harry123180/AIforSensorCurrent/sch/BOM_Board1_PCB1_2024-08-11.xlsx

No. | Quantity | Comment | Designator | Footprint | Value | Manufacturer Part | Manufacturer | Supplier Part | Supplier | LCSC Stock | JLCPCB Stock | LCSC Price | JLCPCB Price | Layer
1 | 1 | KH-CR1220-2 | BAT1 | BAT-SMD_CR1220-2 |  | KH-CR1220-2 | kinghelm(金航标) | C5365933 | LCSC | 7752 | 0 | 0.1306 | 0.831 | B
2 | 2 | 10uF | C1,C7 | C0603 | 10uF | CC0603MRX5R8BB106 | YAGEO(国巨) | C596327 | LCSC | 11864 | 466 | 0.0455 | 0.291 | T
3 | 1 | 100nF | C2 | C0603 | 100nF | CC0603MRX7R8BB104 | YAGEO(国巨) | C2168700 | LCSC | 4772 | 4978 | 0.0030 | 0.0187 | B
4 | 1 | 1nF | C3 | C0603 | 1nF | AC0603JRNPO9BN102 | YAGEO(国巨) | C149612 | LCSC |  | 10 |  | 0.0536 | B
5 | 1 | 22pF | C4 | C0603 | 22pF | CC0603JRNPO9BN220 | YAGEO(国巨) | C105620 | LCSC |  | 1175893 |  | 0.0138 | B
6 | 1 | 1uF | C5 | C0603 | 1uF | AC0603KRX7R7BB105 | YAGEO(国巨) | C3905328 | LCSC | 9779 | 3309 | 0.0212 | 0.135 | T
7 | 1 | 100nF | C6 | C0603 | 100nF | CC0603KPX7R7BB104 | YAGEO(国巨) | C2649559 | LCSC |  | 0 | 0.0065 | 0.042 | T
8 | 1 | 22uF | C8 | C0603 | 22uF | CC0603MRX5R5BB226 | YAGEO(国巨) | C109448 | LCSC | 86703 | 74212 | 0.0193 | 0.123 | T
9 | 4 | 10uF | C9,C11,C16,C17 | C0603 | 10uF | CC0603MRX5R8BB106 | YAGEO(国巨) | C596327 | LCSC | 11864 | 466 | 0.0455 | 0.291 | B
10 | 5 | 100nF | C10,C12,C13,C14,C18 | C0603 | 100nF | CC0603KPX7R7BB104 | YAGEO(国巨) | C2649559 | LCSC |  | 0 | 0.0065 | 0.042 | B
11 | 1 | 22uF | C15 | C0603 | 22uF | CC0603MRX5R5BB226 | YAGEO(国巨) | C109448 | LCSC | 86703 | 74212 | 0.0193 | 0.123 | B
12 | 2 | 1N4148WT | D1,D3 | SOD-523_L1.2-W0.8-LS1.6-RD |  | 1N4148WT | BORN(伯恩半导体) | C511874 | LCSC | 85068 | 54704 | 0.0133 | 0.0844 | B
13 | 1 | KT-0805G | D2 | LED0805-R-RD |  | KT-0805G | KENTO | C2297 | LCSC |  | 965729 |  | 0.0634 | T
14 | 1 | ILHB0603ER121V | FB1 | L0603 |  | ILHB0603ER121V | VISHAY(威世) | C845116 | LCSC | 3250 | 2647 | 0.0513 | 0.326 | T
15 | 1 | XH2.54-2P | J1 | CONN-SMD_2P-P2.50-WT |  | XH2.54-2P |  | C9900004348 | LCSC |  | 0 |  |  | T
16 | 2 | Jumper3 | J3,J4 | HDR-TH_3P-P2.54-V-M-A |  | Jumper3 |  | C2940050 | LCSC |  | 0 |  |  | T
17 | 1 | 2.2uH | L1 | L0603 | 2.2uH | MLZ1608A2R2WT000 | TDK | C76797 | LCSC | 2773 | 3071 | 0.0394 | 0.25 | T
18 | 1 | 2.2uH | L2 | L0603 | 2.2uH | MLZ1608A2R2WT000 | TDK | C76797 | LCSC | 2773 | 3071 | 0.0394 | 0.25 | B
19 | 1 | DNP | R1 | R0603 | DNP | AF0603FR-0741K2L | YAGEO(国巨) |  | LCSC |  |  |  |  | T
20 | 1 | 15Ω | R2 | R0603 | 15Ω | RT0603BRB0715RL | YAGEO(国巨) | C860136 | LCSC | 5000 | 0 | 0.1384 | 0.884 | T
21 | 2 | 0 | R3,R4 | R0603 | 0 | AF0603FR-0741K2L | YAGEO(国巨) |  | LCSC |  |  |  |  | T
22 | 3 | 2kΩ | R5,R6,R7 | R0603 | 2kΩ | RT0603BRD072KL | YAGEO(国巨) | C728588 | LCSC | 82183 | 31601 | 0.0258 | 0.164 | T
23 | 1 | 280Ω | R8 | R0603 | 280Ω | RT0603BRD07280RL | YAGEO(国巨) | C861277 | LCSC | 2595 | 0 | 0.0240 | 0.153 | T
24 | 1 | 10kΩ | R9 | R0603 | 10kΩ | RT0603FRE1310KL | YAGEO(国巨) | C4226066 | LCSC | 16279 | 16483 | 0.0103 | 0.0655 | T
25 | 1 | 3.3kΩ | R10 | R0603 | 3.3kΩ | RT0603BRD073K3L | YAGEO(国巨) | C309653 | LCSC | 203844 | 164803 | 0.0242 | 0.154 | T
26 | 1 | 1kΩ | R11 | R0603 | 1kΩ | AT0603BRD071KL | YAGEO(国巨) | C855701 | LCSC | 976 | 1279 | 0.0699 | 0.445 | B
27 | 1 | 0 | R12 | R0603 | 0 | AF0603FR-0741K2L | YAGEO(国巨) |  | LCSC |  |  |  |  | B
28 | 1 | 100kΩ | R13 | R0603 | 100kΩ | RT0603BRB07100KL | YAGEO(国巨) | C860056 | LCSC | 2845 | 0 | 0.1389 | 0.884 | B
29 | 1 | 8.06kΩ | R14 | R0603 | 8.06kΩ | RT0603BRE078K06L | YAGEO(国巨) | C862307 | LCSC | 7364 | 3702 | 0.0249 | 0.158 | B
30 | 1 | 33kΩ | R15 | R0603 | 33kΩ | RC0603FR-0733KL | YAGEO(国巨) | C126359 | LCSC |  | 192196 |  | 0.00732 | B
31 | 3 | 3.3kΩ | R16,R17,R18 | R0603 | 3.3kΩ | RT0603BRD073K3L | YAGEO(国巨) | C309653 | LCSC | 203844 | 164803 | 0.0242 | 0.154 | B
32 | 4 | 4.7kΩ | R19,R20,R21,R22 | R0603 | 4.7kΩ | AT0603BRD074K7L | YAGEO(国巨) | C855887 | LCSC | 5035 | 4335 | 0.0699 | 0.445 | T
33 | 1 | SS-12F45G4-RS | SW1 | SW-TH_L8.7-W4.6_SS-12F45G4-RS |  | SS-12F45G4-RS |  | C9900012779 | LCSC |  | 0 |  |  | T
34 | 1 | TS-1009S-03826 | SW2 | SW-SMD_4P-L4.5-W4.5-P3.00-LS7.0 |  | TS-1009S-03826 | XUNPU(讯普) | C455243 | LCSC | 30353 | 24290 | 0.0535 | 0.34 | T
35 | 1 | GT-TF003-H0185-01 | TF1 | TF-SMD_GT-TF003-H0185-01 |  | GT-TF003-H0185-01 | G-Switch(品赞) | C5155563 | LCSC | 7872 | 2808 | 0.1328 | 0.845 | B
36 | 1 | Test-Point | TP1 | Test-Point-0.5mm |  |  |  |  |  |  |  |  |  | B
37 | 1 | Test-Point | TP2 | Test-Point-0.5mm |  |  |  |  |  |  |  |  |  | T
38 | 1 | ETA6003Q3Q | U1 | QFN-16_L3.0-W3.0-P0.50-TL-EP1.7-2 |  | ETA6003Q3Q | ETA(钰泰） | C5455585 | LCSC | 5631 | 4079 | 0.4492 | 2.86 | T
39 | 1 | AMS1117-3.3 | U2 | SOT-223-3_L6.5-W3.4-P2.30-LS7.0-BR |  | AMS1117-3.3 | AMS | C6186 | LCSC |  | 448573 |  | 0.664 | B
40 | 1 | ETA1038S2G | U3 | SOT-23-6_L2.9-W1.6-P0.95-LS2.8-BR |  | ETA1038S2G | ETA(钰泰) | C7465552 | LCSC | 2053 | 2051 | 0.1930 | 1.236 | B
41 | 1 | MX8500-8.5-02P-BK01-Cu-S-A | U4 | CONN-TH_2P-P8.50_MX8500-8.5-02P |  | MX8500-8.5-02P-BK01-Cu-S-A | MAX(迈旭) | C5188506 | LCSC | 16565 | 11710 | 0.1619 | 1.0304 | T
42 | 1 | ACS712ELCTR-05B-T | U5 | SOIC-8_L5.0-W4.0-P1.27-LS6.0-BL |  | ACS712ELCTR-05B-T | ALLEGRO(美国埃戈罗) | C44471 | LCSC |  | 6549 |  | 9.81 | T
43 | 1 | 74VHC125FT(BJ) | U6 | TSSOP-14_L5.0-W4.4-P0.65-LS6.4-BL |  | 74VHC125FT(BJ) | TOSHIBA(东芝) | C5331506 | LCSC | 4980 | 0 | 0.2398 |  | B
44 | 1 | PCF8563TS/5,118 | U7 | TSSOP-8_L3.0-W3.0-P0.65-LS4.9-BL |  | PCF8563TS/5,118 | NXP(恩智浦) | C27397 | LCSC |  | 21195 |  | 4.07 | B
45 | 1 | 32.768kHz | X1 | OSC-SMD_2P-L2.0-W1.2 | 32.768kHz | 7RC32768F07UC | SJK(晶科鑫) | C252397 | LCSC |  | 1834 |  | 3.07 | B
