harry123180/AIforSensorCurrent/sch/SCH_AIforSensor電流原理圖_2024-09-10.pdf

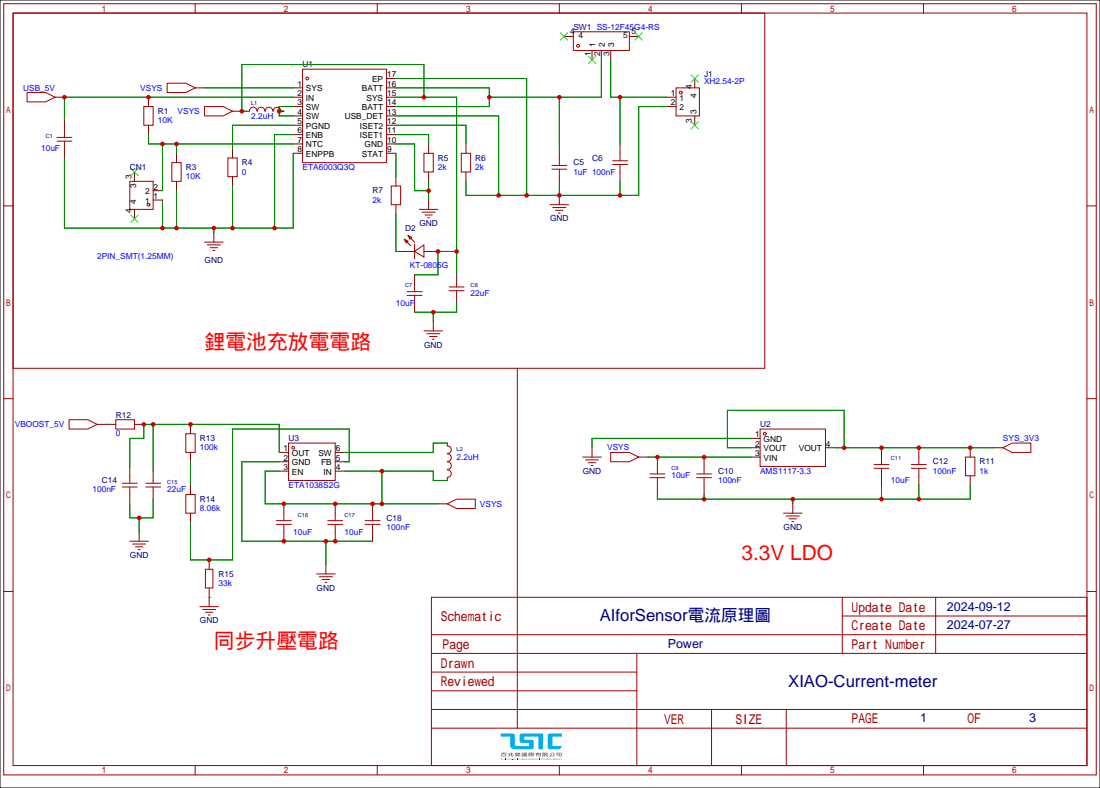
[picture p3: page 1]

GND 10 ISET1 11 ISET2 12 USB_DET 13 BATT 14 SYS 15 BATT 16 EP 17

# LoRa模組 UART接口

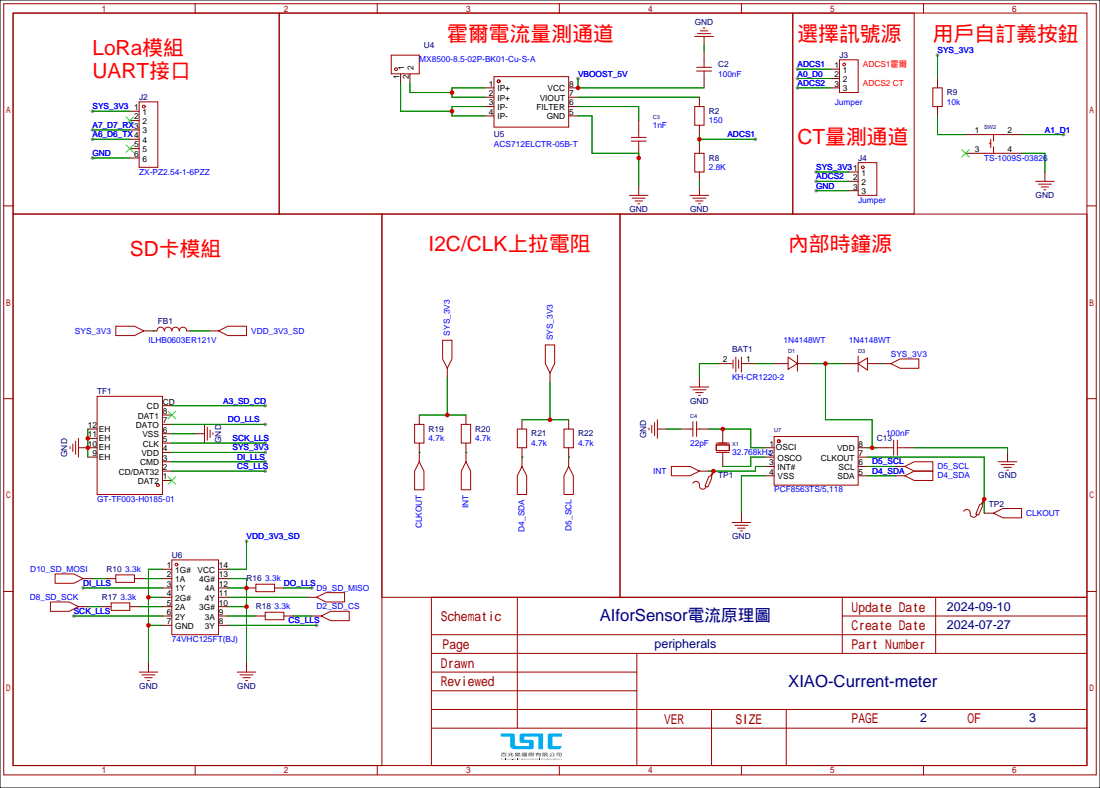
[picture p4: page 2]

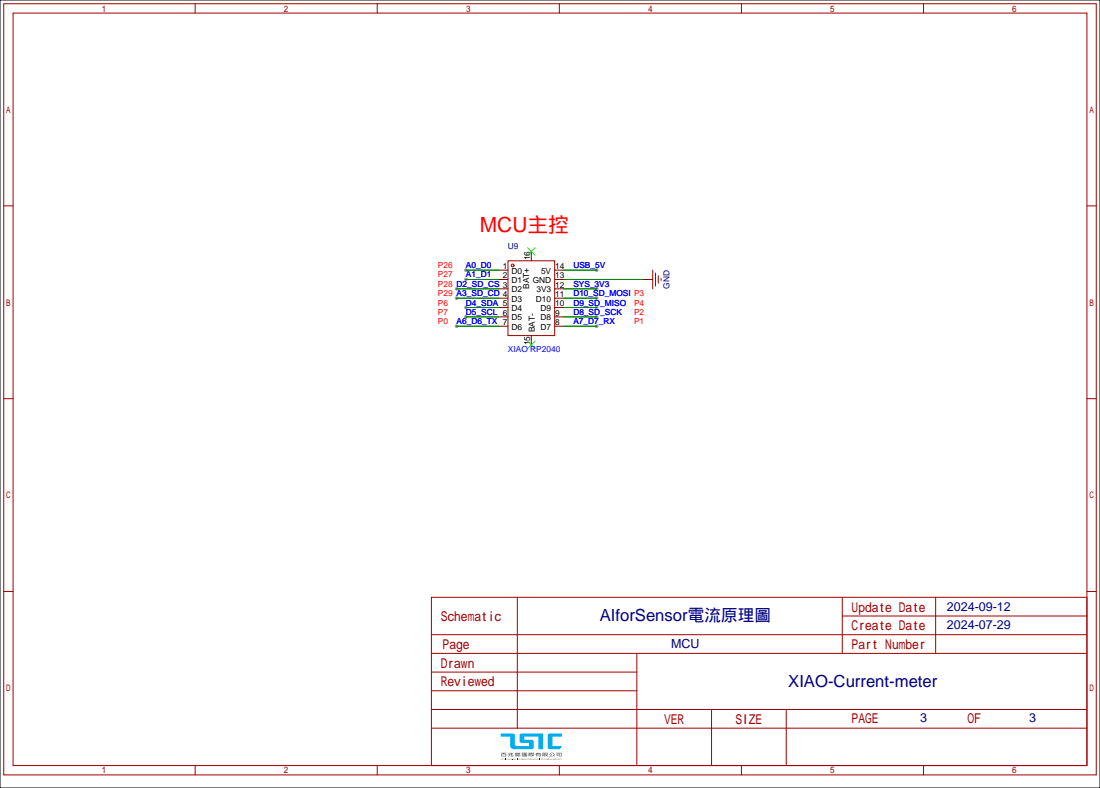
[picture p5: page 3]
