harry123180/AIforSensorCurrent/testDATA/case0.data00000.csv

timestamp | data
0 | -1.239996
1 | -1.978326
2 | -1.634038
3 | -1.780860
4 | -2.486285
5 | -2.969071
6 | -3.170471
7 | -1.494952
8 | -2.639492
9 | -0.624593
10 | -3.724888
11 | -2.360373
12 | -0.480024
13 | -2.722079
14 | -0.077727
15 | -3.659981
16 | -0.369484
17 | -3.589962
18 | -0.312089
19 | -1.969795
20 | -0.510843
21 | -2.666961
22 | -1.230362
23 | -1.772215
24 | -2.552339
25 | -3.872025
26 | -0.565956
27 | -3.604062
28 | -0.491730
29 | -2.202964
30 | -2.271230
31 | -1.574928
32 | -0.288649
33 | -1.342857
34 | -2.418539
35 | -2.246124
36 | -1.391500
37 | -0.284546
38 | -0.203427
39 | -2.770657
40 | -1.614068
41 | -0.867695
42 | -2.647879
43 | -0.778989
44 | -0.231213
45 | -3.734107
46 | -0.571653
47 | -0.091127
48 | -0.441415
49 | -1.818897
50 | -0.542513
51 | -2.168909
52 | -0.799122
53 | -0.505178
54 | -0.712726
55 | -3.257095
56 | -3.654940
57 | -1.447377
58 | -3.064688
59 | -2.149113
60 | -3.970320
61 | -1.459958
62 | -2.314996
63 | -0.185367
64 | -3.159518
65 | -0.116998
66 | -2.954990
67 | -0.571743
68 | -1.674669
69 | -1.170727
70 | -2.856099
71 | -2.727185
72 | -1.424193
73 | -0.565927
74 | -1.324440
75 | -2.227401
76 | -3.776420
77 | -0.890189
78 | -1.621230
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
