harry123180/AIforSensorCurrent/testDATA/case0.data00001.csv

timestamp | data
0 | -3.848890
1 | -3.035609
2 | -0.138995
3 | -2.728789
4 | -2.476278
5 | -1.356430
6 | -0.417437
7 | -2.401066
8 | -2.619269
9 | -2.400540
10 | -2.002425
11 | -1.328653
12 | -2.722422
13 | -3.017039
14 | -1.560987
15 | -1.977198
16 | -1.722330
17 | -1.570909
18 | -1.604362
19 | -0.033178
20 | -3.462531
21 | -1.851019
22 | -3.898769
23 | -2.334646
24 | -3.010603
25 | -3.270852
26 | -3.672319
27 | -0.164857
28 | -1.955024
29 | -0.317446
30 | -1.457725
31 | -1.979598
32 | -0.507826
33 | -1.316056
34 | -0.068918
35 | -3.684131
36 | -2.858505
37 | -2.869472
38 | -2.006489
39 | -3.878309
40 | -1.058861
41 | -1.439372
42 | -2.658652
43 | -3.248786
44 | -1.173412
45 | -0.502793
46 | -2.902019
47 | -0.563541
48 | -3.050311
49 | -2.671634
50 | -2.273319
51 | -0.933656
52 | -1.773477
53 | -3.537131
54 | -1.834961
55 | -1.307813
56 | -1.626354
57 | -1.251049
58 | -0.212042
59 | -0.534190
60 | -1.314661
61 | -1.851359
62 | -1.515875
63 | -3.285571
64 | -1.393462
65 | -3.666803
66 | -2.459283
67 | -1.206495
68 | -0.519032
69 | -3.688876
70 | -3.157256
71 | -0.653548
72 | -3.422044
73 | -3.193937
74 | -0.806672
75 | -0.129090
76 | -3.560266
77 | -0.302039
78 | -3.710243
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
