harry123180/AIforSensorCurrent/testDATA/case0.data00002.csv

timestamp | data
0 | -3.634640
1 | -0.016934
2 | -2.393057
3 | -3.340542
4 | -1.118551
5 | -1.268116
6 | -2.293104
7 | -1.537375
8 | -3.692855
9 | -1.656706
10 | -3.108236
11 | -3.526292
12 | -0.803984
13 | -0.840845
14 | -0.262030
15 | -1.500724
16 | -1.011718
17 | -1.424442
18 | -2.910399
19 | -1.136180
20 | -1.258854
21 | -3.664200
22 | -2.242522
23 | -3.273062
24 | -0.534773
25 | -0.469187
26 | -0.960502
27 | -2.226145
28 | -2.449471
29 | -0.083223
30 | -0.068246
31 | -1.505183
32 | -1.040660
33 | -1.289397
34 | -3.425417
35 | -3.928666
36 | -2.250988
37 | -2.046913
38 | -0.404427
39 | -0.015441
40 | -3.165550
41 | -3.780356
42 | -0.865489
43 | -2.753167
44 | -2.952998
45 | -0.221317
46 | -0.238599
47 | -1.272489
48 | -1.582304
49 | -1.867944
50 | -2.412675
51 | -1.335393
52 | -1.924069
53 | -1.366374
54 | -2.236004
55 | -2.351338
56 | -0.569330
57 | -2.998425
58 | -2.024612
59 | -3.194927
60 | -0.487717
61 | -0.201518
62 | -0.448717
63 | -1.853609
64 | -0.329413
65 | -2.600248
66 | -3.695809
67 | -3.904794
68 | -3.949392
69 | -0.956369
70 | -3.788409
71 | -0.495193
72 | -1.936027
73 | -3.103118
74 | -0.033530
75 | -1.435637
76 | -2.577761
77 | -3.596770
78 | -0.372944
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
