harry123180/AIforSensorCurrent/testDATA/case0.data00003.csv

timestamp | data
0 | -3.040708
1 | -1.201231
2 | -2.015930
3 | -1.941272
4 | -3.910778
5 | -1.724695
6 | -2.825497
7 | -2.700707
8 | -1.457453
9 | -1.014684
10 | -2.336489
11 | -3.040864
12 | -3.716502
13 | -1.813312
14 | -3.669997
15 | -0.054404
16 | -0.161615
17 | -2.978085
18 | -0.748295
19 | -1.656368
20 | -1.987453
21 | -2.669544
22 | -3.521240
23 | -2.065075
24 | -1.736976
25 | -3.491928
26 | -0.051515
27 | -1.329881
28 | -1.952869
29 | -0.590096
30 | -1.268657
31 | -1.413448
32 | -1.656765
33 | -2.578532
34 | -2.958176
35 | -2.448449
36 | -0.243753
37 | -3.247859
38 | -3.260256
39 | -1.998830
40 | -1.565073
41 | -0.982532
42 | -1.977122
43 | -0.601761
44 | -1.100630
45 | -0.077436
46 | -1.467125
47 | -2.423095
48 | -3.426642
49 | -3.885075
50 | -3.579880
51 | -2.702019
52 | -0.632288
53 | -2.828292
54 | -1.239824
55 | -1.709104
56 | -0.137178
57 | -2.582881
58 | -1.114330
59 | -3.002176
60 | -3.806032
61 | -0.862639
62 | -2.237276
63 | -3.317117
64 | -0.496969
65 | -2.668622
66 | -2.002120
67 | -3.134218
68 | -1.039506
69 | -1.946721
70 | -3.762543
71 | -3.065265
72 | -0.295430
73 | -0.561258
74 | -3.431236
75 | -0.198624
76 | -0.887167
77 | -0.844857
78 | -2.661534
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
