harry123180/AIforSensorCurrent/testDATA/case0.data00004.csv

timestamp | data
0 | -1.929185
1 | -0.625690
2 | -3.677653
3 | -2.169532
4 | -2.234667
5 | -0.742540
6 | -0.657272
7 | -1.872583
8 | -1.738761
9 | -3.848011
10 | -2.738796
11 | -2.947851
12 | -2.390603
13 | -2.862664
14 | -0.306033
15 | -2.455131
16 | -0.136911
17 | -1.264098
18 | -2.229245
19 | -1.511766
20 | -0.460676
21 | -2.793400
22 | -0.816605
23 | -3.354080
24 | -1.198535
25 | -1.578269
26 | -3.518183
27 | -1.742993
28 | -0.610466
29 | -1.748540
30 | -2.916652
31 | -1.485459
32 | -3.877348
33 | -1.502387
34 | -2.990479
35 | -0.132552
36 | -2.329429
37 | -3.368976
38 | -1.410338
39 | -2.640268
40 | -3.639776
41 | -3.057101
42 | -0.643884
43 | -1.734695
44 | -0.998599
45 | -2.467352
46 | -1.096962
47 | -1.879808
48 | -1.929463
49 | -0.635372
50 | -3.880961
51 | -2.845755
52 | -0.349157
53 | -0.842417
54 | -3.395113
55 | -3.406183
56 | -0.964567
57 | -3.046064
58 | -2.476174
59 | -3.062520
60 | -0.483779
61 | -0.439873
62 | -1.988962
63 | -0.548101
64 | -0.488802
65 | -2.404700
66 | -0.865866
67 | -1.625970
68 | -3.249519
69 | -3.633436
70 | -1.825102
71 | -2.499814
72 | -2.894859
73 | -1.018542
74 | -3.358412
75 | -1.541552
76 | -3.758435
77 | -1.852208
78 | -3.556365
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
