harry123180/AIforSensorCurrent/testDATA/case0.data00005.csv

timestamp | data
0 | -1.642933
1 | -0.975531
2 | -1.357018
3 | -0.450054
4 | -0.599737
5 | -2.897431
6 | -3.126398
7 | -2.193950
8 | -0.922641
9 | -0.300848
10 | -1.183418
11 | -0.818572
12 | -3.521550
13 | -2.980533
14 | -2.417259
15 | -0.085234
16 | -3.169618
17 | -0.792064
18 | -1.542520
19 | -1.828950
20 | -2.248421
21 | -2.396840
22 | -2.964611
23 | -3.244298
24 | -3.215698
25 | -0.833188
26 | -2.420919
27 | -0.410629
28 | -0.599825
29 | -2.802533
30 | -3.357294
31 | -1.164284
32 | -1.865472
33 | -3.538549
34 | -2.910302
35 | -3.653800
36 | -2.140375
37 | -1.851823
38 | -2.948196
39 | -2.861916
40 | -0.183188
41 | -2.718887
42 | -0.970040
43 | -1.621155
44 | -2.284755
45 | -1.766342
46 | -2.658205
47 | -2.379414
48 | -2.448123
49 | -2.004490
50 | -1.346783
51 | -1.621858
52 | -3.706297
53 | -1.999469
54 | -3.610670
55 | -0.606957
56 | -0.741376
57 | -2.995004
58 | -3.477061
59 | -3.062142
60 | -0.075750
61 | -3.319760
62 | -2.293502
63 | -1.646254
64 | -0.679038
65 | -0.543759
66 | -2.089462
67 | -1.628913
68 | -1.825984
69 | -3.584858
70 | -2.940921
71 | -1.513782
72 | -0.182156
73 | -2.657477
74 | -3.071537
75 | -3.949027
76 | -2.655267
77 | -0.946427
78 | -0.066165
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
