harry123180/AIforSensorCurrent/(commit log)

2024-11-07 update dataset
    [Class0.data00000.csv, Class0.data00001.csv, Class0.data00002.csv, Class0.data00003.csv, Class0.data00004.csv, Class0.data00005.csv, Class0.data00006.csv, Class0.data00007.csv]
2026-08-20 Update LICENSE copyright holder to 百兆鍶國際有限公司
2026-10-14 Add CLAUDE.md with project and hardware guidance
    Documents the picochu TinyML current-sensing board: Arduino/RP2040 toolchain
    setup, the Lab1-Lab7s sketch progression, the vendored Edge Impulse inference
    library, dataset layout and the external (Edge Impulse) training flow.
    Claude-Session: https://claude.ai/code/session_01NU3dCRKUissoYD2qptWVTK
